TudorPavalau/Drone/doc_drona_pmp.pdf

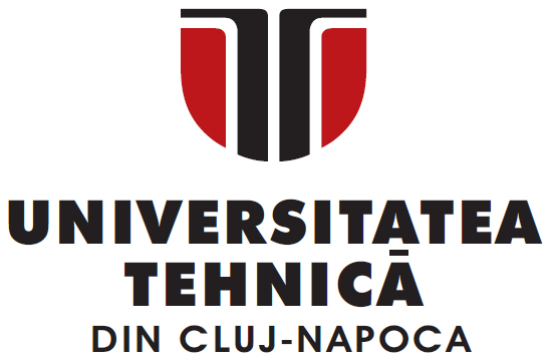
[picture p1: figure]

# Drona ESP32

# Proiectare cu Microprocesoare

### Autor: Păvălău Tudor-Stefan

### Grupa: 30236

Facultatea de Automatica

si Calculatoare

## Cuprins

1 Introducere: Scop s, i Motivat, ie | 2
2 Studiu Bibliografic s, i Analiză Comparativă | 2
3 Solut, ia Propusă s, i Implementare | 2
4 Testare s, i Validare | 4
5 Raport de Daune s, i Riscuri Asumate | 4
6 Concluzii s, i Direct, ii Viitoare | 5

## 1 Introducere: Scop s, i Motivat, ie

Proiectul vizează proiectarea s, i implementarea unui sistem de control al zborului (Flight Controller) pentru un quadcopter, utilizând microcontroller-ul ESP32. Motivat, ia principală a acestui demers nu este replicarea unei solut, ii comerciale ”gata făcute”, ci înt,elegerea profundă a algoritmilor de stabilizare, a filtrării semnalelor digitale s, i a protocolului de comunicare cu sistemele de propulsie (ESC).
Domeniul vehiculelor aeriene fără pilot (UAV) este unul vast, însă majoritatea solut, iilor hobby (ex. Betaflight) ascund complexitatea matematică în spatele unor interfet,e grafice. Scopul acestui proiect este construirea unui sistem ”de la zero”, care să permită controlul fin al turat, iei motoarelor în funct, ie de datele furnizate de giroscop, demonstrând capacitatea de a ment, ine orizontalitatea vehiculului într-un sistem instabil mecanic.
Am ales arhitectura ESP32 datorită puterii de procesare (dual-core), care permite rularea buclei de control PID simultan cu un server Web pentru telemetrie, oferind un avantaj net fat,ă de plăcile clasice Arduino Uno.

## 2 Studiu Bibliografic s, i Analiză Comparativă

În faza preliminară, au fost analizate trei abordări distincte pentru realizarea unităt, ii de control. Tabelul de mai jos sintetizează diferent,ele dintre solut, iile existente s, i solut, ia propusă.

Tabela 1: Analiza comparativă a solut, iilor de Flight Controller
Criteriu | Solut, ie Comercială
| (ex. Betaflight/F4) | Arduino Uno (At-
| | mega328p)
Solut, ia | Propusă
| | | (ESP32)
Cost | Ridicat | Scăzut | Mediu-Scăzut
Flexibilitate | Scăzută (Blackbox) | Ridicată | Maximă
Putere Calcul | Foarte Mare (STM32) Mică (16 MHz) | Mare (240 MHz)
Conectivitate | Necesită modul extern Necesită modul extern WiFi / Bluetooth in-
| | | tegrat
Protocol ESC | DShot / Multishot | PWM Standard | PWM(writeMicroseconds)
Debugging | Port USB/OSD | Serial Monitor | WiFi Telemetry(Web)

Solut, ia bazată pe ESP32 a fost aleasă deoarece permite ajustarea parametrilor de zbor ”în aer” (Over-the-Air) prin intermediul unei interfet,e Web, eliminând necesitatea conectării fizice prin cablu USB pentru fiecare modificare a constantelor PID.

## 3 Solut, ia Propusă s, i Implementare

### 3.1 Arhitectura Generală

Sistemul este construit în jurul unui microcontroller ESP32 WROOM, interfat,at cu un senzor inert, ial (IMU) MPU6050 s, i patru variatoare de turat, ie (ESC). Configurat, ia aleasă pentru cadru este de tip ”+”, unde motoarele sunt dispuse pe axele cardinale (Fat,ă, Spate, Stânga, Dreapta), simplificând ecuat, iile de mixare a motoarelor.

### 3.2 Descrierea Algoritmului de Control

Nucleul software este o buclă de control care rulează la o frecvent,ă ridicată (aprox. 50Hz în modul WebServer, optimizabil). Procesul decizional urmează pas, ii:
1. **Achizit, ie Date:** Citirea valorilor brute de accelerat, ie s, i giroscop via I2C. 2. **Filtrare:** Aplicarea unui Complementary Filter pentru eliminarea zgomotului mecanic indus de vibrat, ii.
Anglef ilt = 0.8 × Anglevechi + 0.2 × Anglenou | (1)
3. **Control P (Proport, ional):** Calcularea erorii fat,ă de orizontală (SetPoint = 0).
Output = Kp × Error | (2)

Unde Kp (Gain) a fost setat experimental la valoarea 2.0 pentru stabilitate. 4. **Mixare:** Combinarea semnalului de bază (Throttle) cu corect, iile calculate pentru Pitch (Fat,ă/Spate) s, i Roll (Stânga/Dreapta).

### 3.3 Hardware s, i Conexiuni

O particularitate a ESP32 este matricea GPIO flexibilă. Spre deosebire de Arduino, pinii I2C nu sunt fics, i.
- **Senzor MPU6050:** Conectat pe pinii SDA (GPIO 33) s, i SCL (GPIO 32). Această configurare atipică a necesitat init, ializarea explicită a librăriei Wire.
- **Motoare:** Conectate pe pinii digitali 26 (Fat,ă), 27 (Dreapta), 14 (Spate), 25 (Stânga).

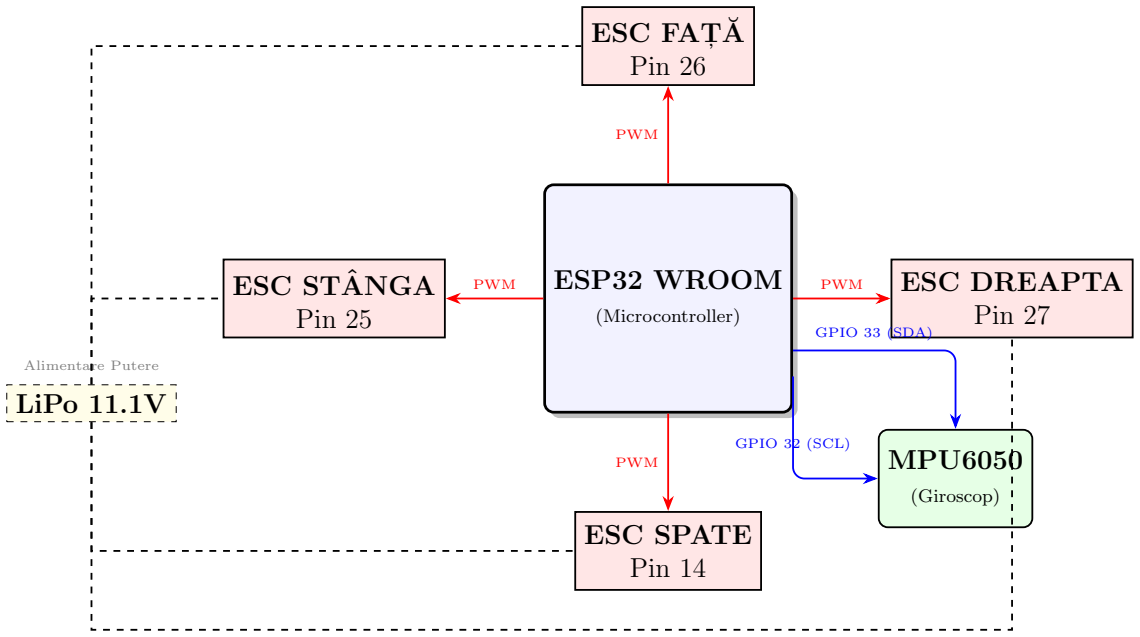
[picture p2: figure]
ESP32 WROOM; (Microcontroller); ESC FAT, A˘; Pin 26; ESC SPATE Pin 14; ESC STANGA ˆ; Pin 25; ESC DREAPTA Pin 27; MPU6050; (Giroscop); PWM; GPIO 33 (SDA); GPIO 32 (SCL); LiPo 11.1V; Alimentare Putere

Figura 1: Schema conexiunilor hardware: ESP32, MPU6050 s, i ESC-uri.

### 3.4 Implementare Software

Un aspect critic a fost controlul precis al ESC-urilor. Funct, ia standard write(0-180) s-a dovedit inadecvată din cauza rezolut, iei scăzute. Solut, ia implementată utilizează funct, ia writeMicroseconds(1000-2000), care oferă 1000 de trepte de rezolut, ie s, i respectă standardul industrial al protocoalelor PWM pentru drone.

## 4 Testare s, i Validare

Procesul de validare a fost iterativ, întâmpinând probleme majore specifice sistemelor de zbor.

### 4.1 Problema 1: Comunicarea I2C s, i Adresarea

Init, ial, senzorul MPU6050 nu a putut fi detectat. Cauza a fost dublă:

1. Librăria standard căuta senzorul pe pinii default (21, 22), în timp ce hardware-ul utiliza (33, 32).
2. Rezolvarea a constat în apelarea explicită: Wire.begin(33, 32).

### 4.2 Problema 2: Instabilitatea Mecanică (”Flip of Death”)

În primele teste de zbor, drona prezenta un comportament violent de răsturnare instantanee la decolare. Cauza: Valoarea Kp (Proportional Gain) era setată la 6.0, o valoare prea mare care amplifica vibrat, iile mecanice, creând o buclă de feedback pozitiv. De asemenea, lipsa filtrării software permitea zgomotului senzorului să ajungă direct la motoare.
Solut, ia:
- Reducerea Kp la 2.0.
- Introducerea filtrului complementar (80% istoric / 20% nou) pentru netezirea citirilor.

### 4.3 Date Experimentale de Calibrare

Tabelul următor prezintă evolut, ia comportamentului sistemuluiîn funct, ie de parametrii modificat, i.

Tabela 2: Evolut, ia stabilităt, ii sistemului în timpul testelor
Fază Testare | P GAIN Filtrare | Rezultat Observat
Test Init, ial | 6.0 | Nu | Oscilat, ii violente, Răsturnare (Flip)
Test Intermediar | 3.0 | Nu | Oscilat, ii rapide, supraîncălzire ESC
Test Corect, ie Sens | 3.0 | Nu | Identificare motoare inversate
Configurat, ie Finală 2.0 | Da (0.8/0.2) Decolare stabilă controlată

### 4.4 Testul ”În Mână”

Pentru a valida direct, ia de corect, ie fără a risca distrugerea elicelor, s-a efectuat un test static. La înclinarea manuală a dronei spre stânga, sistemul a răspuns prin cres,terea turat, iei (RPM) motorului stâng, confirmând logica corectă de stabilizare (motorul ”jos” trebuie să accelereze pentru a ridica brat,ul).

## 5 Raport de Daune s, i Riscuri Asumate

Dezvoltarea experimentală a implicat s, i costuri materiale neprevăzute, cauzate de natura iterativă a procesului de învăt,are (trial and error) s, i de erori umane în manipularea componentelor sub tensiune. Pe parcursul proiectului au fost înregistrate următoarele pierderi hardware:

- 2 x ESP32 DEVKITv1: Arse ireversibil în urma unor conexiuni eronate la pinii de alimentare sau scurtcircuite pe linia de 3.3V.

- 1 x ESC (Electronic Speed Controller): Ars ireversibil în urma unei conexiuni eronate.
- 1 x Giroscop MPU6050: Ars ireversibil.
- 1 x Placă de bază Laptop: Incident major cauzat de lipsa izolării galvanice în timpul conectării simultane a dronei la bateria LiPo (14.8V) s, i la portul USB al laptopului pentru debugging.

Acest ultim incident subliniază important,a utilizării unui izolator USB în timpul dezvoltării sistemelor alimentate de surse externe de putere mare.

## 6 Concluzii s, i Direct, ii Viitoare

Proiectul a demonstrat fezabilitatea construirii unui Flight Controller utilizând componente generice s, i accesibile. Obiectivele init, iale au fost atinse:

- Sistemul cites,te corect orientarea spat, ială.
- Comunicarea cu ESC-urile este precisă prin protocolul Microseconds.
- Algoritmul de stabilizare react, ionează corect la perturbat, ii, evitând fenomenele de rezonant,ă distructivă prin filtrare software adecvată.

O inovat, ie personală adusă proiectului este interfat,a Web integrată, care permite vizualizarea în timp real a parametrilor RPM s, i a înclinării, o funct, ionalitate care pe sistemele comerciale necesită echipamente de telemetrie dedicate s, i costisitoare.

### 6.1 Dezvoltare Ulterioară

Pentru evolut, ia proiectului de la stadiul de prototip experimental la un vehicul aerian autonom performant, se propun următoarele etape de dezvoltare hardware s, i software:

1. Implementarea Controlului prin Joystick Fizic: Des, i interfat,a Web este utilă pentru telemetrie, pilotajul necesită o latent,ă minimă s, i precizie tactilă. Se propune dezvoltarea unui transmit,ător dedicat (bazat tot pe ESP32) care să comunice prin protocolul ESP-NOW sau integrarea unui receptor radio clasic (SBUS/PPM).
2. Ment, inerea Automată a Altitudinii (Altitude Hold): Integrarea unui senzor barometric de precizie (ex. BMP280). Prin măsurarea presiunii atmosferice, sistemul va putea ajusta automat accelerat, ia (Throttle) pentru a ment, ine drona la o cotă fixă.
3. Navigat, ie s, i Autopilot: Transformarea dronei într-un sistem autonom prin adăugarea unui modul GPS. Aceasta va permite funct, ii avansate precum Return to Home (RTH) s, i executarea misiunilor pe puncte (Waypoints).
